johnsonm/y-bushing-blocks/(commit log)

2018-07-07 Initial version to print
    [y-bushing-blocks.scad]
2018-07-07 Attempt to fix over-constraint by holding bushings in the middle
    [y-bushing-blocks.scad]
2018-07-07 Format for thingiverse customizer
    [y-bushing-blocks.scad]
2018-07-07 Make distance between installed blocks a thingiverse customizer parameter
    [y-bushing-blocks.scad]
2018-07-07 Example part sources; add background bearing cylinder to model
    [y-bushing-blocks.scad]
2018-07-08 Adjust parameters for thingiverse customizer
    [y-bushing-blocks.scad]
2018-07-18 Offset clip; add extra screw holes for more mounting options
    [y-bushing-blocks.scad]
2018-07-21 Add clearance around bushings, default to 15mm length
    When printing with small rail_d, it became clear that between
    printing imprecision and bearing size imprecision, it was possible
    for the rail to bind due to incompatible Z constraint. Add a
    channel in the base to accomodate this imprecision and avoid
    excess constraint. Remove material from the bottom of the clip
    to expose the channel and make it effective.
    Reduce the default rail_d as the previous diameter was too large
    and allowed too much slop. This was resulting in X axis yaw during
    Y axis reversal.
    Note that the new bushing_clearance parameter is intentionally
    not accounted for in the clip sizing, since that is intended to
    flex a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
    [y-bushing-blocks.scad]
2018-07-22 Add allowance for variance to clip profile
    If the clips are too tight (due to imprecision in either the print
    or the bushings) they will push the bushings up away from the base
    and out of alignment with the rail holes, causing the bushings to
    bind. Apply the bushing clearance to the clips as well as the base.
    Also, if the bushing is too tight end to end, the end blocks will
    flex and push the bushing out, with the same end result. A little
    extra length will not cause trouble, so add it.
    [y-bushing-blocks.scad]
2018-07-23 Add screw-tightened bracket option
    [y-bushing-blocks.scad]
2018-07-23 Thicker bracket around screws; shorter bracket clamps to hold tighter
    [y-bushing-blocks.scad]
2018-07-24 Even shorter bracket clamps to hold tighter
    [y-bushing-blocks.scad]
2018-08-07 Specify length of screw bracket separately; increase length
    [y-bushing-blocks.scad]
